gruvin/chibi-cw/shield-pcb/parts_layout/chibi-cw-F_SilkS.png

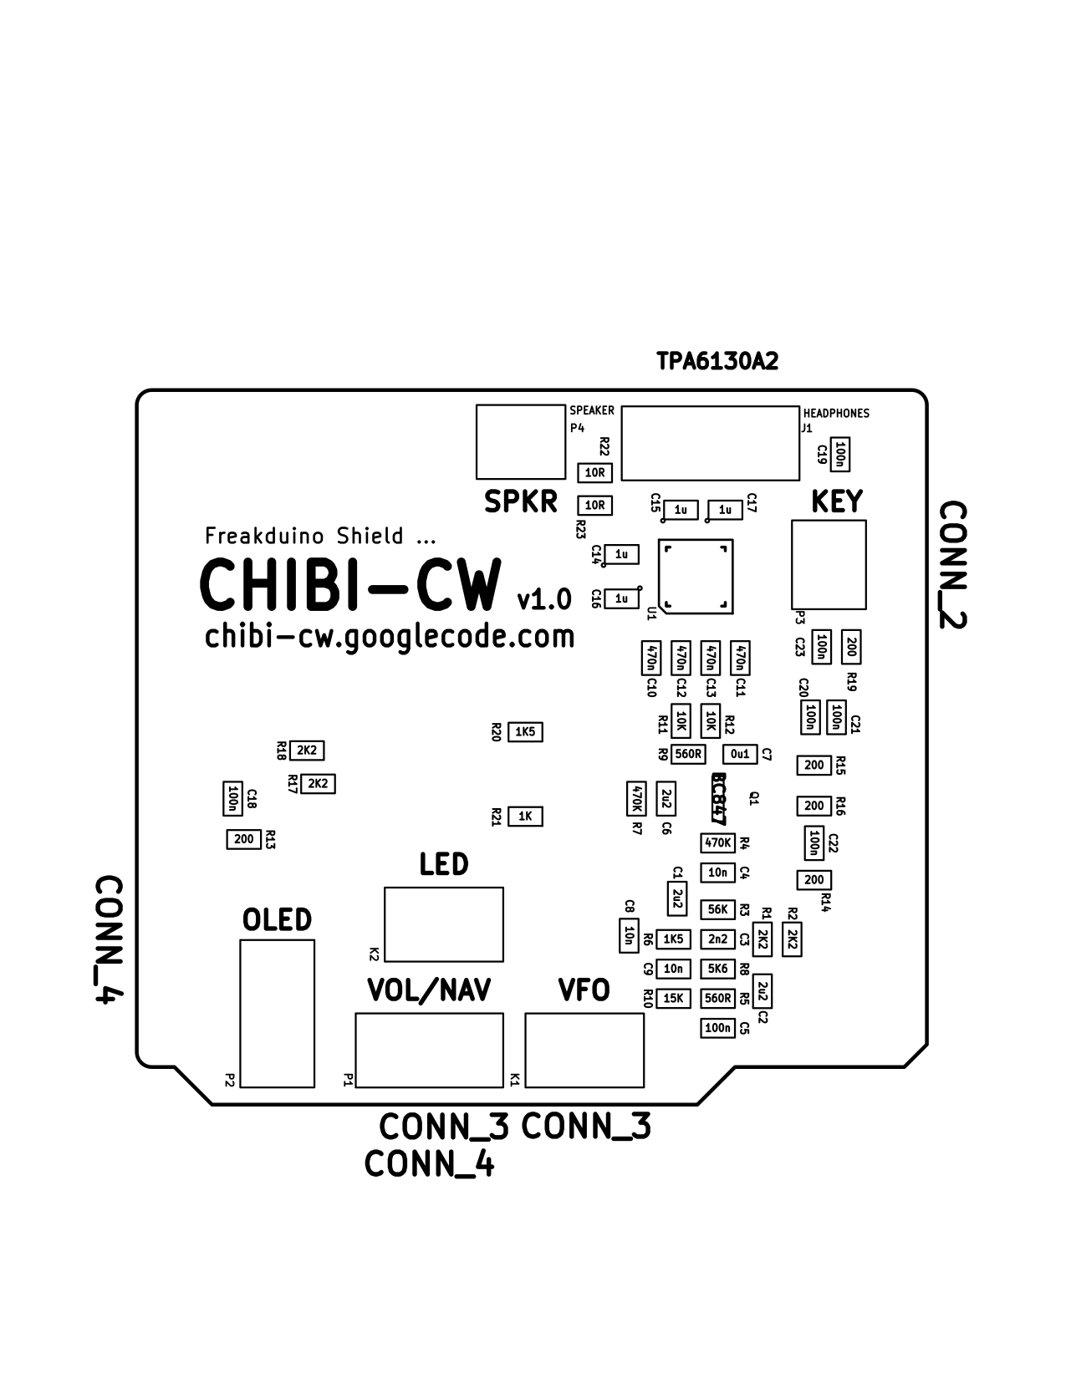
shield-pcb/parts_layout/chibi-cw-F_SilkS.png
