gruvin/chibi-cw/shield-pcb/chibi-cw.kicad_pcb

## KiCad design shield-pcb/chibi-cw.kicad_pcb (2013-10-28)

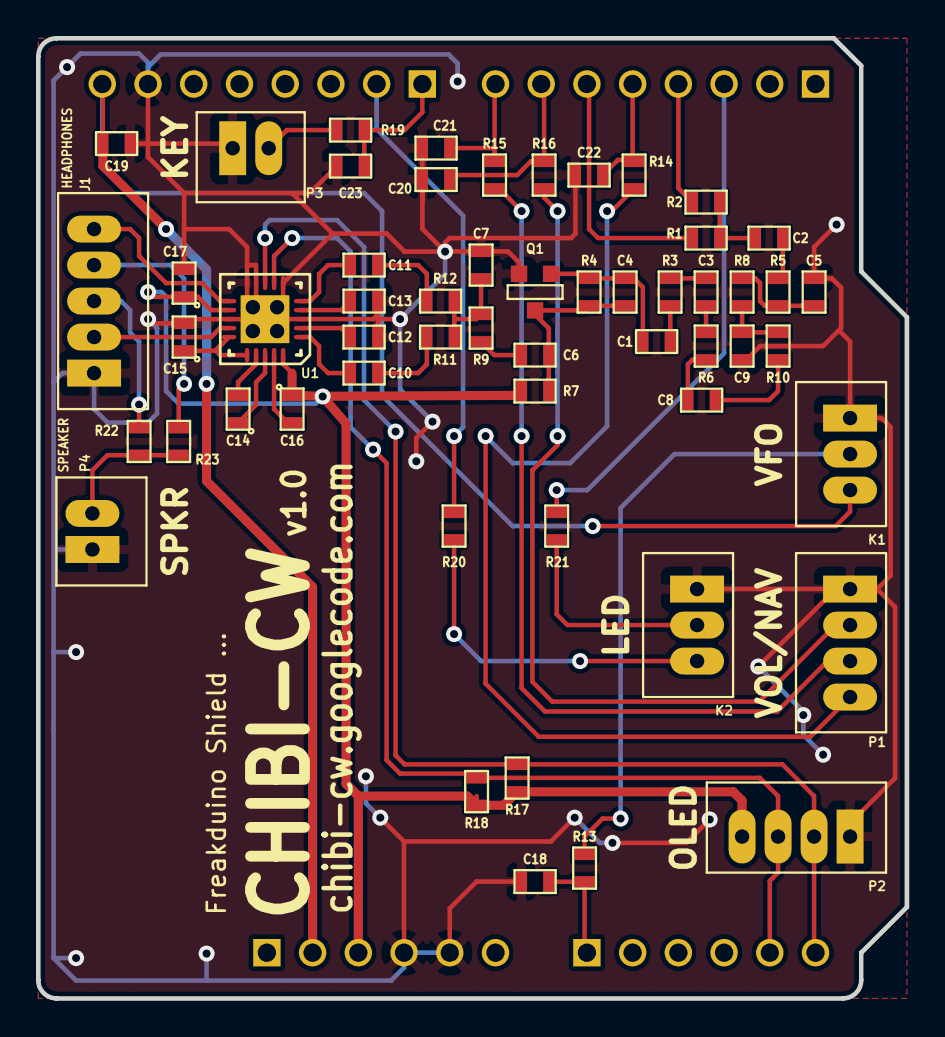
[picture p2: board chibi-cw.kicad_pcb from above]

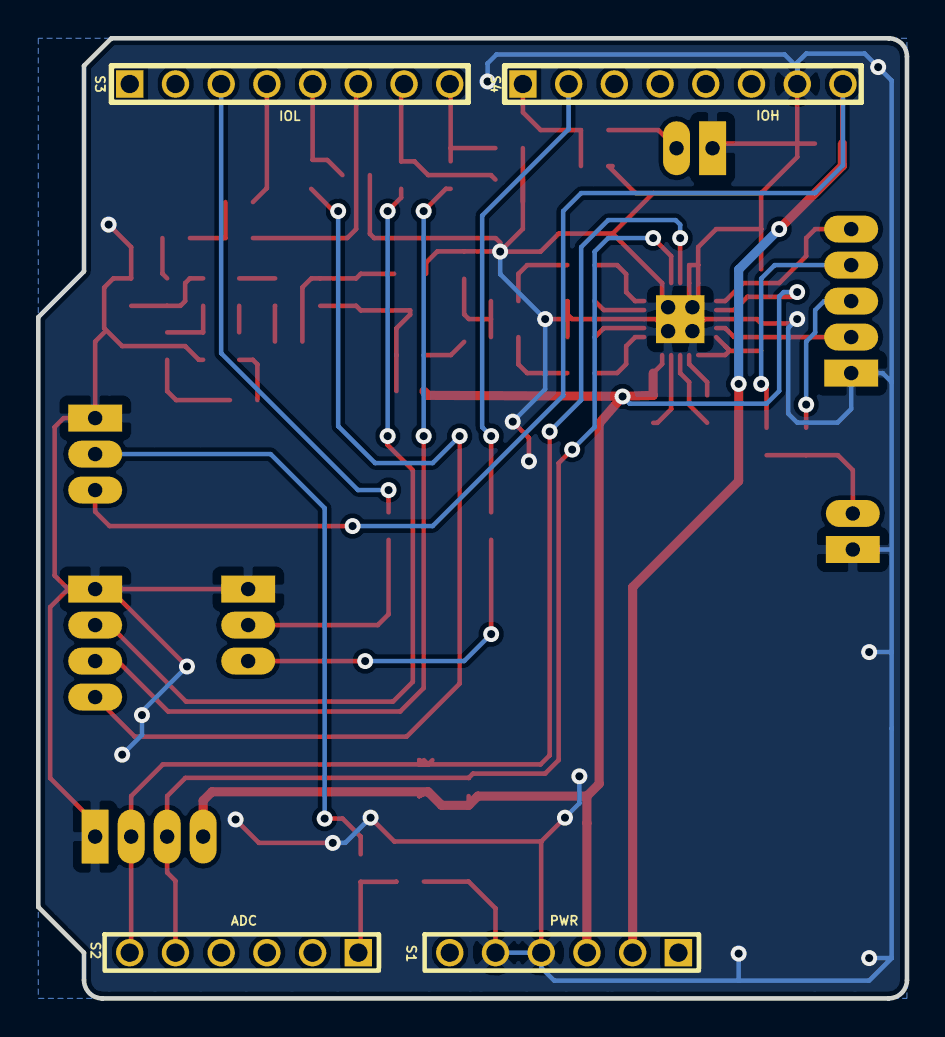
[picture p3: board chibi-cw.kicad_pcb from below]

Board: 2 copper layers, 48.3 x 53.3 mm, 59 parts (4 on the bottom side), 49 nets.

Parts:
C1, C2, C6: 2u2; SM0603
C3: 2n2; SM0603
C4, C8, C9: 10n; SM0603
C5, C18, C19, C20, C21, C22, C23: 100n; SM0603
C7: 0u1; SM0603
C10, C11, C12, C13: 470n; SM0603
C14, C15, C16, C17: 1u; SM0603_CPOL
J1: HEADPHONES; CONN_2MM_5x1
K1, K2: CONN_3; CONN_2MM_3x1
P1, P2: CONN_4; CONN_2MM_4x1
P3: CONN_2; CONN_2MM_2x1
P4: SPEAKER; CONN_2MM_2x1
Q1: BC847; SOT23EBC
R1, R2, R17, R18: 2K2; SM0603
R3: 56K; SM0603
R4, R7: 470K; SM0603
R5, R9: 560R; SM0603
R6, R20: 1K5; SM0603
R8: 5K6; SM0603
R10: 15K; SM0603
R11, R12: 10K; SM0603
R13, R14, R15, R16, R19: 200; SM0603
R21: 1K; SM0603
R22, R23: 10R; SM0603
S1: PWR; pin_array_6x1
S2: ADC; pin_array_6x1
S3: IOL; pin_array_8x1
S4: IOH; pin_array_8x1
U1: TPA6130A2; QFN20

Connections:
3.3V: C19.2, K1.3, S1.2, S4.8
5V: C16.1, C17.1, P2.4, R7.2, R17.2, R18.2, S1.3, U1.12, U1.20
AD0: C18.2, R13.1, S2.1
AD4/SDA: P2.3, R18.1, S2.5, U1.7
AD5/SCL: P2.2, R17.1, S2.6, U1.8
GND: C5.1, C7.2, C9.1, C12.1, C13.1, C15.2, C17.2, C18.1, C19.1, C20.1, C21.1, C22.1, C23.1, J1.1, K1.1, K2.1, P1.1, P2.1, P3.1, P4.1, Q1.1, S1.4, S1.5, S4.7, U1.3, U1.6, U1.9, U1.10, U1.13
IO2: R21.1, S3.3
IO3: R2.1, S3.4
IO4: C22.2, R14.1, S3.5
IO5: R1.1, S3.6
IO6: C20.2, R16.1, S3.7
IO7: C21.2, R15.1, S3.8
IO8: C23.2, R19.1, S4.1
IO9: R20.1, S4.2
unnamed: K1.2, R13.2
unnamed: C1.2, C4.1, Q1.2, R4.1
unnamed: P1.2, R16.2
unnamed: P1.4, R14.2
unnamed: P1.3, R15.2
unnamed: C15.1, U1.15, U1.16
unnamed: C13.2, U1.4
unnamed: C11.2, U1.5
unnamed: C11.1, R12.2
unnamed: C12.2, U1.2
unnamed: C10.2, U1.1
unnamed: C10.1, R11.2
unnamed: J1.2, U1.14
unnamed: J1.5, U1.11
unnamed: C6.2, R9.2
unnamed: C2.1, R1.2, R2.2
unnamed: C7.1, R9.1, R11.1, R12.1
unnamed: K2.2, R21.2
unnamed: K2.3, R20.2
unnamed: P3.2, R19.2
unnamed: P4.2, R22.2, R23.2
unnamed: J1.4, R23.1
unnamed: J1.3, R22.1
unnamed: C2.2, R5.1
unnamed: C1.1, R3.2
unnamed: C3.1, R3.1
unnamed: C8.1, R6.2
unnamed: C3.2, R6.1
unnamed: C9.2, R8.2, R10.2
unnamed: C8.2, R10.1
unnamed: C5.2, R5.2, R8.1
unnamed: C14.1, U1.18
unnamed: C14.2, U1.17
unnamed: C16.2, U1.19
unnamed: C4.2, C6.1, Q1.3, R4.2, R7.1
