gruvin/chibi-cw/shield-pcb/chibi-cw.sch

## KiCad design shield-pcb/chibi-cw.sch (2013-11-11)

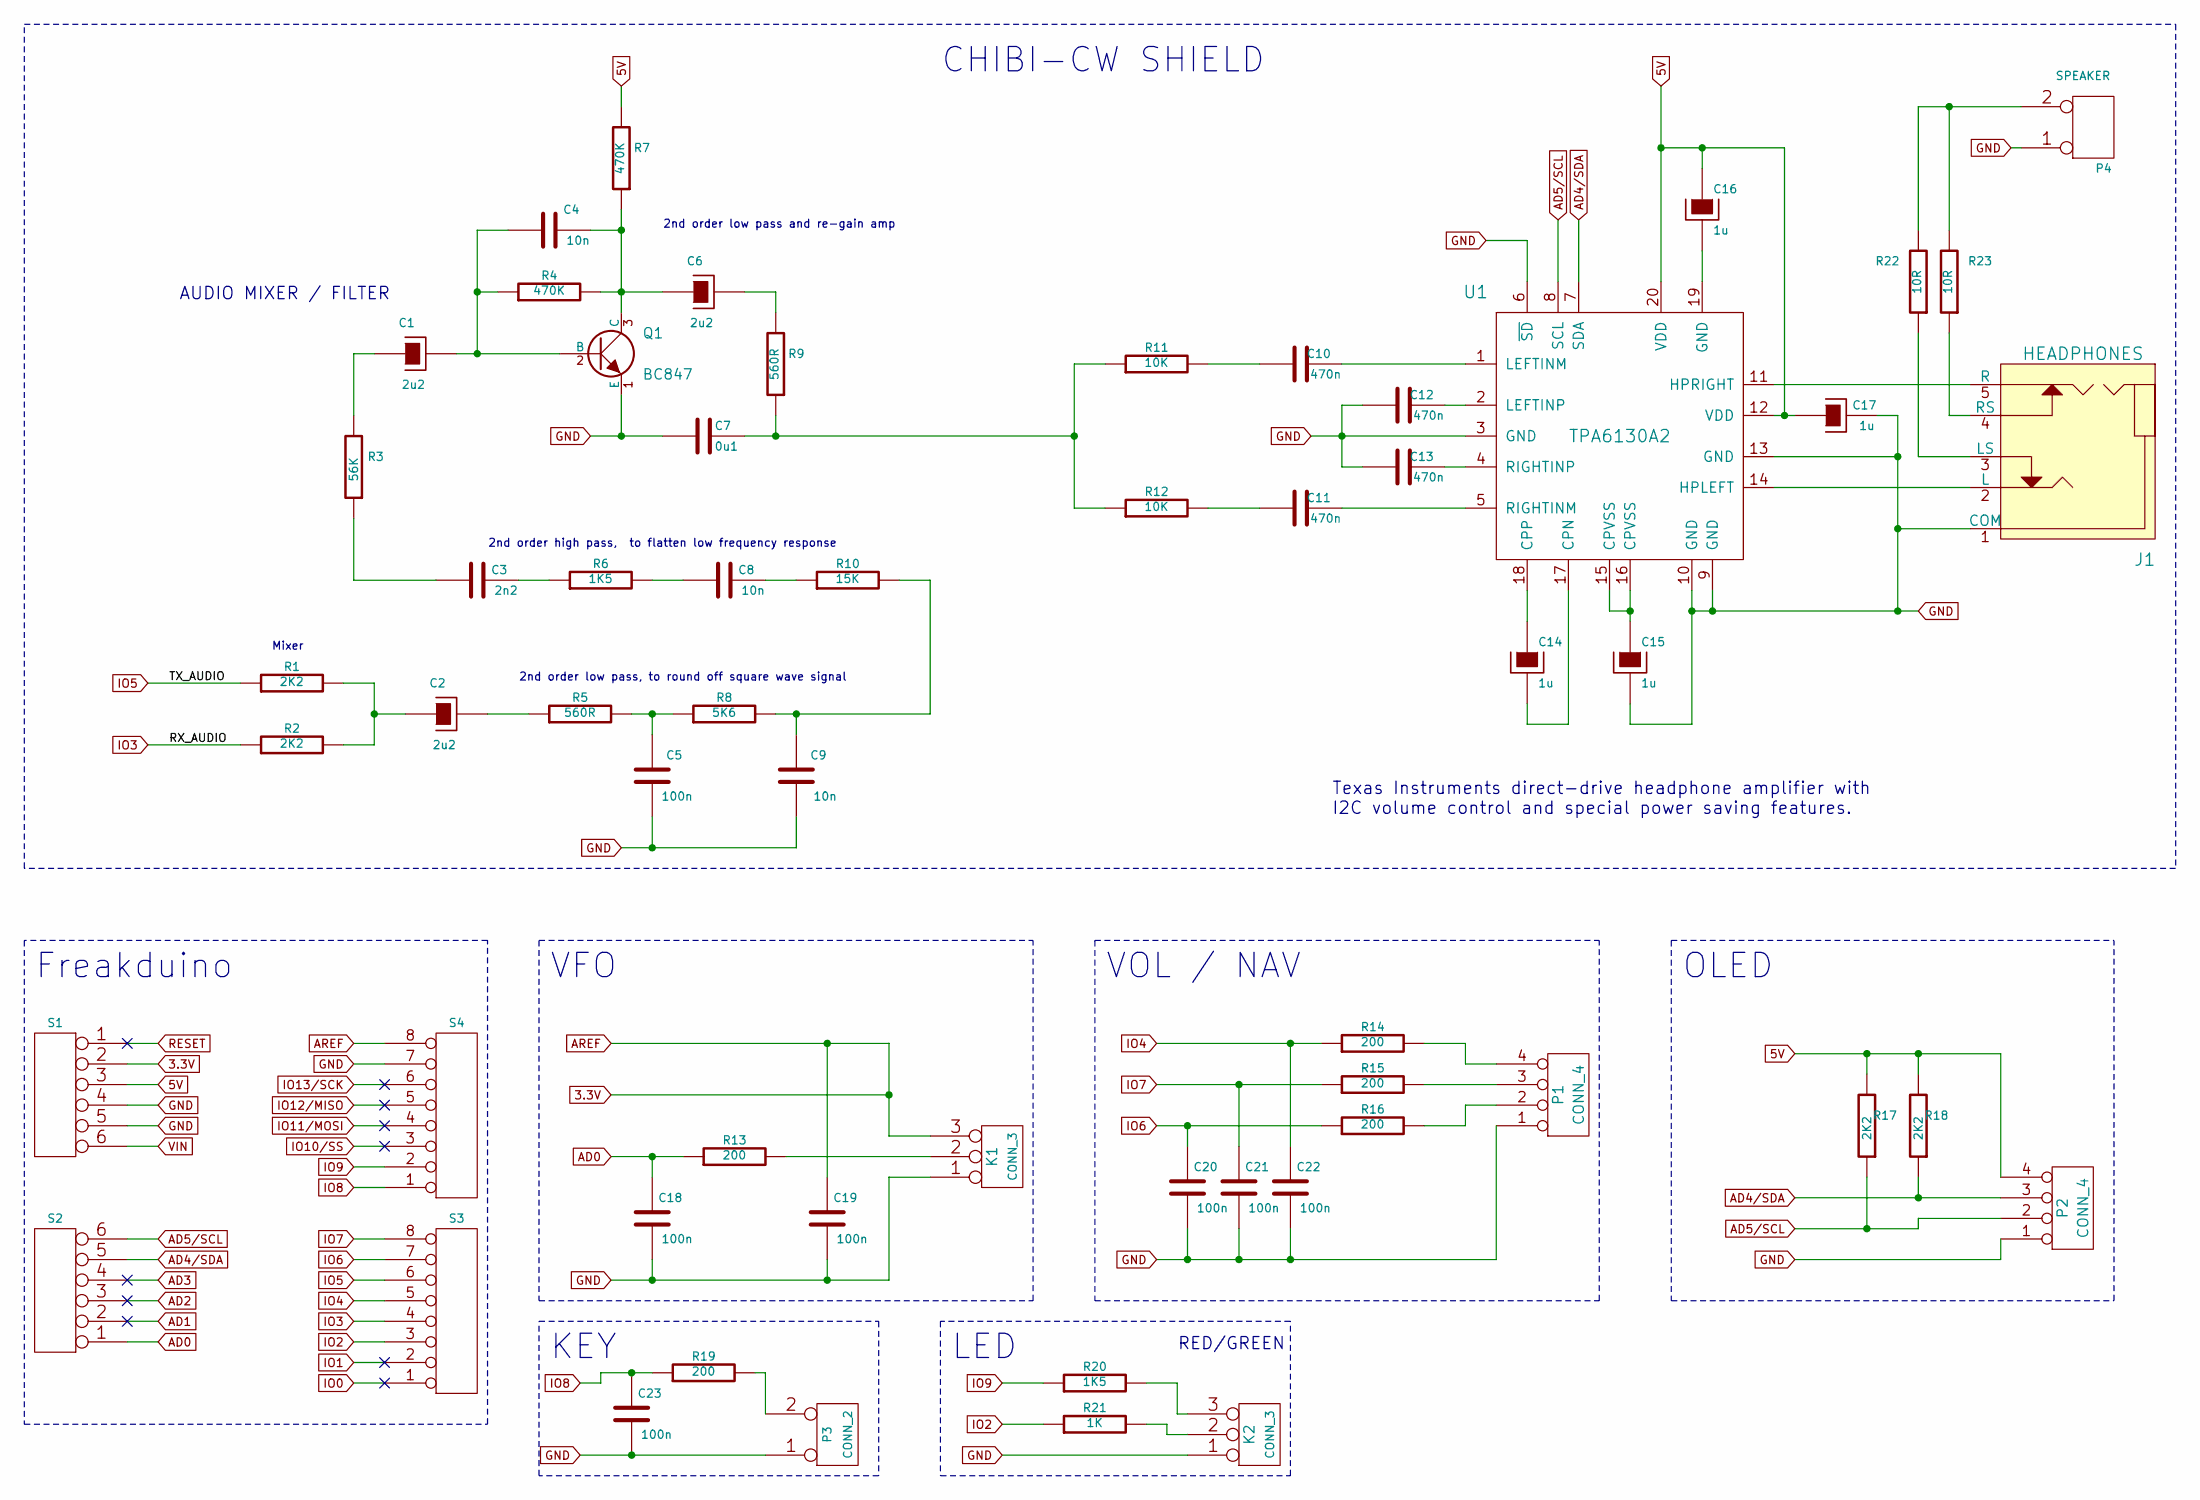
[picture p4: schematic chibi-cw.sch]

Parts:
C1, C2, C6: 2u2
C3: 2n2
C4, C8, C9: 10n
C5, C18, C19, C20, C21, C22, C23: 100n
C7: 0u1
C10, C11, C12, C13: 470n
C14, C15, C16, C17: 1u
J1: HEADPHONES
K1, K2: CONN_3
P1, P2: CONN_4
P3: CONN_2
P4: SPEAKER
Q1: BC847
R1, R2, R17, R18: 2K2
R3: 56K
R4, R7: 470K
R5, R9: 560R
R6, R20: 1K5
R8: 5K6
R10: 15K
R11, R12: 10K
R13, R14, R15, R16, R19: 200
R21: 1K
R22, R23: 10R
S1: PWR
S2: ADC
S3: IOL
S4: IOH
U1: TPA6130A2

Connections:
3.3V: C19.2, K1.3, S1.2, S4.8
5V: C16.1, C17.1, P2.4, R7.2, R17.2, R18.2, S1.3, U1.12 (VDD), U1.20 (VDD)
AD0: C18.2, R13.1, S2.1
AD1: S2.2
AD2: S2.3
AD3: S2.4
AD4/SDA: P2.3, R18.1, S2.5, U1.7 (SDA)
AD5/SCL: P2.2, R17.1, S2.6, U1.8 (SCL)
GND: C5.1, C7.2, C9.1, C12.1, C13.1, C15.2, C17.2, C18.1, C19.1, C20.1, C21.1, C22.1, C23.1, J1.1 (COM), K1.1, K2.1, P1.1, P2.1, P3.1, P4.1, Q1.1 (E), S1.4, S1.5, S4.7, U1.3 (GND), U1.6 (~SD), U1.9 (GND), U1.10 (GND), U1.13 (GND)
IO0: S3.1
IO1: S3.2
IO2: R21.1, S3.3
IO3: R2.1, S3.4
IO4: C22.2, R14.1, S3.5
IO5: R1.1, S3.6
IO6: C20.2, R16.1, S3.7
IO7: C21.2, R15.1, S3.8
IO8: C23.2, R19.1, S4.1
IO9: R20.1, S4.2
IO10/SS: S4.3
IO11/MOSI: S4.4
IO12/MISO: S4.5
IO13/SCK: S4.6
unnamed: C1.1, R3.2
unnamed: C1.2, C4.1, Q1.2 (B), R4.1
unnamed: C2.1, R1.2, R2.2
unnamed: C2.2, R5.1
unnamed: C3.1, R3.1
unnamed: C3.2, R6.1
unnamed: C4.2, C6.1, Q1.3 (C), R4.2, R7.1
unnamed: C5.2, R5.2, R8.1
unnamed: C6.2, R9.2
unnamed: C7.1, R9.1, R11.1, R12.1
unnamed: C8.1, R6.2
unnamed: C8.2, R10.1
unnamed: C9.2, R8.2, R10.2
unnamed: C10.1, R11.2
unnamed: C10.2, U1.1 (LEFTINM)
unnamed: C11.1, R12.2
unnamed: C11.2, U1.5 (RIGHTINM)
unnamed: C12.2, U1.2 (LEFTINP)
unnamed: C13.2, U1.4 (RIGHTINP)
unnamed: C14.1, U1.18 (CPP)
unnamed: C14.2, U1.17 (CPN)
unnamed: C15.1, U1.15 (CPVSS), U1.16 (CPVSS)
unnamed: C16.2, U1.19 (GND)
unnamed: J1.2 (L), U1.14 (HPLEFT)
unnamed: J1.3 (LS), R22.1
unnamed: J1.4 (RS), R23.1
unnamed: J1.5 (R), U1.11 (HPRIGHT)
unnamed: K1.2 (PM), R13.2
unnamed: K2.2 (PM), R21.2
unnamed: K2.3, R20.2
unnamed: P1.2, R16.2
unnamed: P1.3, R15.2
unnamed: P1.4, R14.2
unnamed: P3.2 (PM), R19.2
unnamed: P4.2 (PM), R22.2, R23.2
RESET: S1.1
VIN: S1.6

Notes on the sheet:
Freakduino
AUDIO MIXER / FILTER
2nd order high pass, to flatten low frequency response
2nd order low pass, to round off square wave signal
2nd order low pass and re-gain amp
Mixer
Texas Instruments direct-drive headphone amplifier with I2C volume control and special power saving features.
CHIBI-CW SHIELD
VFO
VOL / NAV
OLED
KEY
LED
RED/GREEN
