gruvin/chibi-cw/shield-pcb/chibi-cw_discrete.sch

## KiCad design shield-pcb/chibi-cw_discrete.sch (2013-08-04)

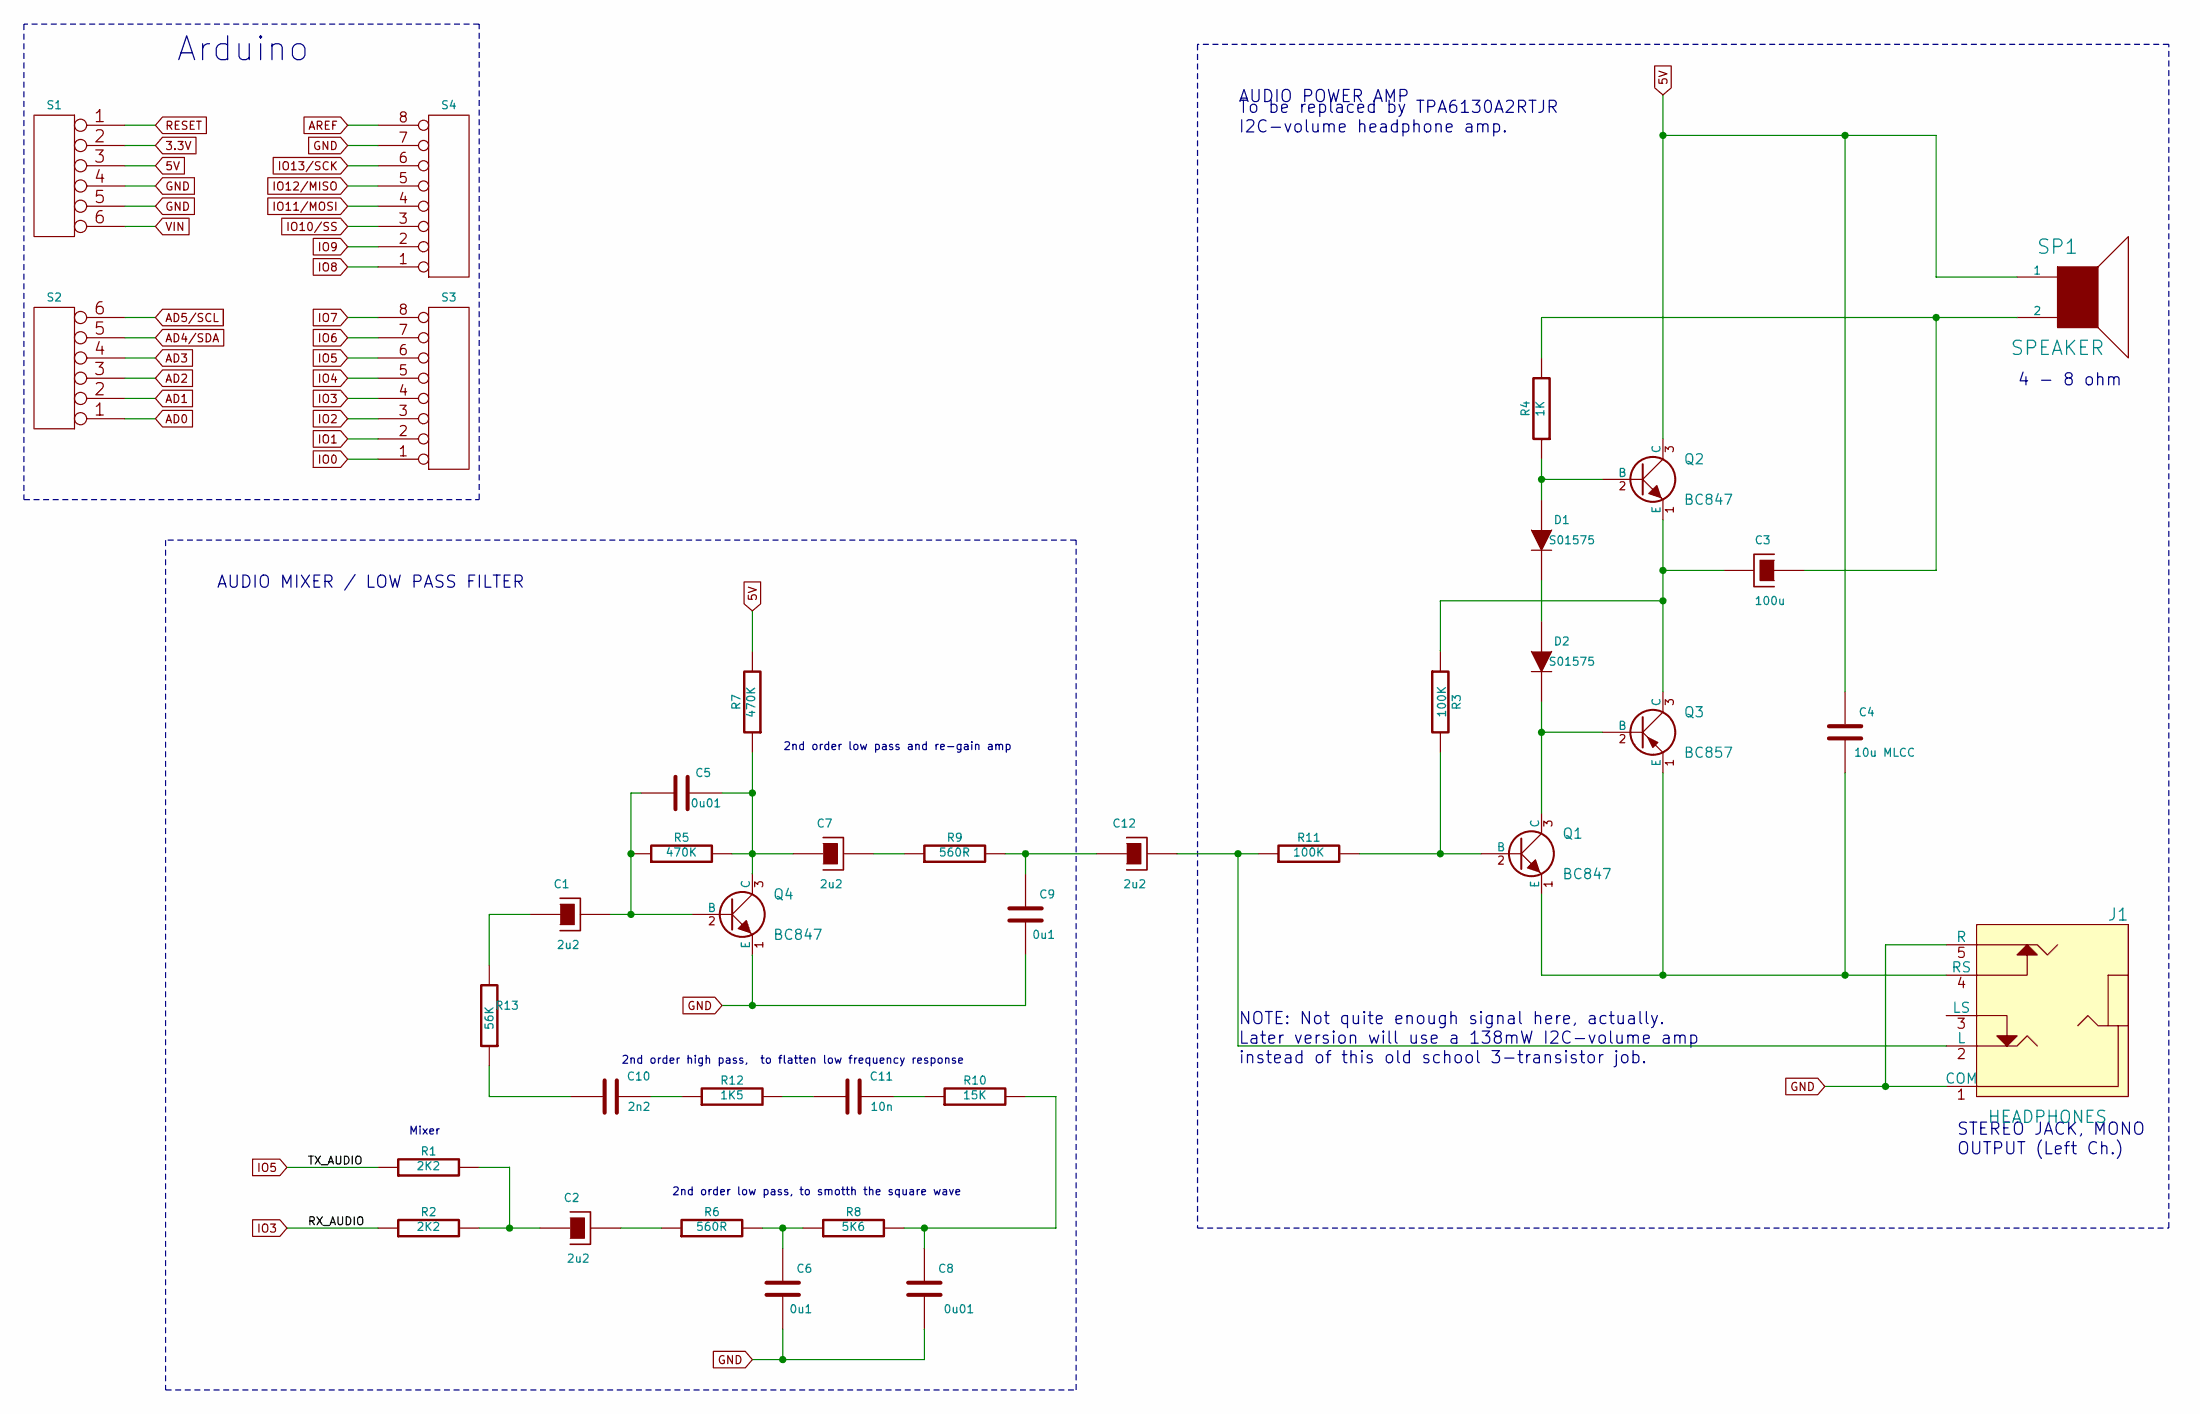
[picture p5: schematic chibi-cw_discrete.sch]

Parts:
C1, C2, C7, C12: 2u2
C3: 100u
C4: 10u MLCC
C5, C8: 0u01
C6, C9: 0u1
C10: 2n2
C11: 10n
D1, D2: S01575
J1: HEADPHONES
Q1, Q2, Q4: BC847
Q3: BC857
R1, R2: 2K2
R3, R11: 100K
R4: 1K
R5, R7: 470K
R6, R9: 560R
R8: 5K6
R10: 15K
R12: 1K5
R13: 56K
S1: PWR
S2: ADC
S3: IOL
S4: IOH
SP1: SPEAKER

Connections:
3.3V: S1.2
5V: C4.2, Q2.3 (C), R7.2, S1.3, SP1.1
AD0: S2.1
AD1: S2.2
AD2: S2.3
AD3: S2.4
AD4/SDA: S2.5
AD5/SCL: S2.6
AREF: S4.8
GND: C6.1, C8.1, C9.1, J1.1 (COM), J1.5 (R), Q4.1 (E), S1.4, S1.5, S4.7
IO0: S3.1
IO1: S3.2
IO2: S3.3
IO3: R2.1, S3.4
IO4: S3.5
IO5: R1.1, S3.6
IO6: S3.7
IO7: S3.8
IO8: S4.1
IO9: S4.2
IO10/SS: S4.3
IO11/MOSI: S4.4
IO12/MISO: S4.5
IO13/SCK: S4.6
unnamed: C1.1, R13.2
unnamed: C1.2, C5.1, Q4.2 (B), R5.1
unnamed: C2.1, R1.2, R2.2
unnamed: C2.2, R6.1
unnamed: C3.1, R4.2, SP1.2
unnamed: C3.2, Q2.1 (E), Q3.3 (C), R3.1
unnamed: C4.1, J1.4 (RS), Q1.1 (E), Q3.1 (E)
unnamed: C5.2, C7.1, Q4.3 (C), R5.2, R7.1
unnamed: C6.2, R6.2, R8.1
unnamed: C7.2, R9.1
unnamed: C8.2, R8.2, R10.2
unnamed: C10.1, R13.1
unnamed: C10.2, R12.1
unnamed: C11.1, R12.2
unnamed: C11.2, R10.1
unnamed: C9.2, C12.1, R9.2
unnamed: C12.2, J1.2 (L), R11.1
unnamed: D1.1 (A), Q2.2 (B), R4.1
unnamed: D1.2 (K), D2.1 (A)
unnamed: D2.2 (K), Q1.3 (C), Q3.2 (B)
unnamed: Q1.2 (B), R3.2, R11.2
RESET: S1.1
VIN: S1.6

Notes on the sheet:
Arduino
4 - 8 ohm
STEREO JACK, MONO OUTPUT (Left Ch.)
AUDIO MIXER / LOW PASS FILTER
AUDIO POWER AMP
NOTE: Not quite enough signal here, actually. Later version will use a 138mW I2C-volume amp instead of this old school 3-transistor job.
2nd order high pass, to flatten low frequency response
To be replaced by TPA6130A2RTJR I2C-volume headphone amp.
2nd order low pass, to smotth the square wave
2nd order low pass and re-gain amp
Mixer
