gruvin/chibi-cw/(commit log)

2013-08-04 Added KEY silk label
    [chibi-cw.kicad_pcb]
2013-08-04 Updated scematic revision number (from 0.2 to 1.0)
    [chibi-cw.sch]
2013-08-05 3D connector parts improved (more accurate size etc)
    [chibi-cw.kicad_pcb, chibi-cw.sch]
2013-08-05 Production files produced and given the eye in Gerbview. Looking OK.
    [chibi-cw.kicad_pcb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]
2013-08-05 Minor improvements to JST XH 2.0 connector 3D models.
2013-08-06 Trivial changes, here and there.
    [chibi-cw.kicad_pcb]
2013-08-21 Comment correction / removal.
    [chibi_cw_radio.ino]
2013-08-21 + Moved 16x16 font date to PROGMEM space. + Modified the Kozig ZT oLED library to accomodate PROGMEN for the one function I'm currently using. + Added modified Kozig ZT OLED library to repository.
2013-08-22 + Enhanced digital protocol now used identitification header byte 0xCC to help filter junk data on the (real) frequency. + New protocol also includes trx of callsigns. These are hard coded but will b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
2013-08-22 oLED delays for better stability of callsign display and erase
    [chibi_cw_radio.ino]
2013-10-28 PCB final check-over OK. Created production files. (Will freeze.)
    [chibi-cw.kicad_pcb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]
2013-10-28 PCB v1.00 tagged (frozen) for production
    Misc other files added.
    [chibi-cw.drl]
2013-10-28 PCB: Just added dimensioning notes to drawings layer.
    [chibi-cw.kicad_pcb]
2013-11-11 Added I2C audio amp chip initialisation code to firmware. Seems to be working fine. The chip appear to completely refuse to drive my 8-ohm speaker through the two 10-ohm resistors. *shrug*
    (+ Trival part reference position move in schematic.)
    [chibi-cw.sch]
2014-02-11 Added Maple JTAG adapteri PCB, to get Gerber files for ITead, because I'm too lazy nowadays to fab my own simple boards. :-P
    Based on Eagle version, referenced from http://wiki.leaflabs.com/index.php?title=Maple_JTAG_How_To
    [jtag-adapter.brd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]
2014-02-11 Added JTAG adapter board dimensions and Gerber ZIP file.
    [jtag-adapter.brd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]
